kokabun/ps1-spdif-fpga/README.md

# PS1 S/PDIF FPGA PoC

> 実施順序（2026-09-04）：[SPU直結からPIOへ移行する計画](docs/direct-to-pio-plan.md)を参照してください。まずPIOを使わず直結で検証し、その後にPIOへ移行します。[共通RTL修正と検証結果](docs/rtl-backport.md)を本ブランチへ反映しました。実機は未検証です。

[SPU直結の暫定回路図・秋月購入リスト](docs/spu-direct-build.md)を追加しました。PS1側の測定を開始しましたが、電気的な適合性は未確認・施工不可です。

以下の構成を対象とする概念実証（PoC）です。

```text
SCPH-7000 / PU-20 (CXD2925Q)
        -> Tang Nano 9K (GW1NR-9)
        -> IEC 60958 / S/PDIF
        -> 秋月電子 109598 (Everlight PLT133/T10W)
```

**まだPlayStationをFPGAへ接続しないでください。** [入力回路の評価案](docs/ps1-input-interface.md)では74LCX541FTを第一候補としましたが、負電圧・入力傾斜・電源遷移が未確認です。電気的適合を確認してから接続します。左右極性・Right-Justifiedのbit位置等は、その後のFPGA受信試験でも確定できます。音声形式のTBDと接続前の電気的条件を区別します。

次の作業は[PS1未接続のLCX541単体試験](docs/input-buffer-test.md)です。端子番号付き配線図、Nano 9K専用の試験信号源、オシロスコープ（使用機：DHO914S）での手順を追加しました。Gowin実ビルド・書込み・入力基板の実測は未実施です。

PCから1コマンドずつ測定・保存する手順は[DHO914S CLI測定手順](docs/input-buffer-measurement.md)を参照してください。元データは本リポジトリ内の`captures/input-buffer/`（各runはGit管理外）、公開確認済みの資料は[入力バッファのエビデンス](docs/evidence/input-buffer/README.md)へ分けて保存します。

## 現在の実装状況

将来構想は[Parallel I/O接続型S/PDIFドングルの設計検討](docs/parallel-io-dongle.md)を参照してください。
一次資料・第三者の報告・未検証の仮説を分けて整理しています。PIO対応は未実装です。

- 移植可能な16-bit Right-Justified PCM receiver
- 移植可能な4エントリ asynchronous FIFO
- IEC 60958 consumer stereo frame generatorおよびBMC出力
- 想定される`384*Fs` WCKOから`128*Fs`への正確なclock-enable分周
- Tang Nano 9K用top、device選択、pin constraints
- 自己検証を行うreceiverおよびtransmitter testbench
- [GW1N-1](platform/tang_nano_gw1n1/README.md)および[GW1NZ-1](platform/tang_nano_1k_gw1nz1/README.md)向けplatformディレクトリの雛形

9K platformはWCKOを直接使用するため、PLLをインスタンス化しません。WCKOが
16.9344 MHz（`384 * 44.1 kHz`）であると確認できれば、WCKO 3周期ごとのpulseが
5.6448 MHzのBMC half-bit rateと正確に一致します。`audio_clock.v`はplatform固有の
wrapperとして分離しているため、測定結果に応じてcoreを変更せずgenerated rPLLへ
置き換えられます。

## 設計

```text
BCKO/LRCO/DATO -> Right-Justified RX --write--> asynchronous FIFO
                                                       |
WCKO -> platform audio_clock -> IEC 60958 + BMC <------read
                                      |
                                  PLT133/T10W
```

receiverは各LRCK slotで最後にsamplingした16 bitを保持します。`LRCK_LEFT`と
`SAMPLE_ON_NEGEDGE` parameterを公開していますが、現在のtop-level設定値は
placeholderであり、CXD2925Qのtimingを確定するものではありません。

transmitterは、channel-status blockごとに192 stereo frame、Z/X/Y preamble、
subframe bit 12〜27の16-bit audio、validity/user/channel-status、even parity、BMCを
出力します。consumer channel-status blockは現在すべて0です。これはconsumer
linear audio、no pre-emphasis、標準の44.1 kHz frequency codeを示します。
professional/copyright/category/word-lengthの詳細化は、このPoCの対象外です。

## PU-20配線候補 — 接続前に測定必須

これまでに確認したreverse-engineering資料から得た作業仮説は次のとおりです。

| CXD2925Q候補 | 機能 | Tang Nano 9K PoC header | FPGA pin |
|---|---|---|---:|
| pin 100 `WCKO` | 16.9344 MHz / 384 Fs想定 | J5-5 | 25 |
| pin 97 `BCKO` | serial bit clock | J5-6 | 26 |
| pin 98 `LRCO` | 44.1 kHz word/channel clock | J5-7 | 27 |
| pin 99 `DATO` | serial PCM | J5-8 | 28 |
| 確認済みのdigital ground | 共通基準電位 | J5 GND | — |

これらのCXD2925Q pin番号とtiming想定は**候補**であり、Sonyのtiming diagramによって
本リポジトリ内で完全に確定したものではありません。対象となるPU-20 revisionで、
ICの向きと導通を確認してください。基板写真だけからpin番号を推定しないでください。

選択したNano 9Kのpin 25〜29はJ5-5〜J5-9へ引き出されており、Sipeed公式回路図では
3.3 V I/O bankに属します。ただし、これはPS1側信号が3.3 V互換であることを証明する
ものではありません。

### LRCO / BCKO / DATO / MCLK測定のエビデンス（2026-09-06）

対象はSCPH-7000 / PU-20。測定者申告の取り出し点は、[ConsoleModsの700x向け手順](https://consolemods.org/wiki/PS1:Digital_Audio_(SPDIF)_Mod)にあるDAC側LRCK/BCK/MCLK点と、手順5の写真で示された基板GND点。
この第三者資料と測定者申告は、CXD2925Q端子までの導通確認やSony一次資料による確定とは区別する。

測定にはRIGOL DHO914S、10X passive probe、DC coupling、20 MHz bandwidth limit OFFを使用した。
測定前に本体のprobe compensation outputを測定し、約3.076 Vpp、平坦な矩形波を確認した。
PS1測定時のGNDは標準の長いワニ口leadで基板GNDへ接続したため、過渡peakにはground-loop inductanceとpickupの影響が含まれ得る。

#### LRCO（ConsoleMods表記LRCK）

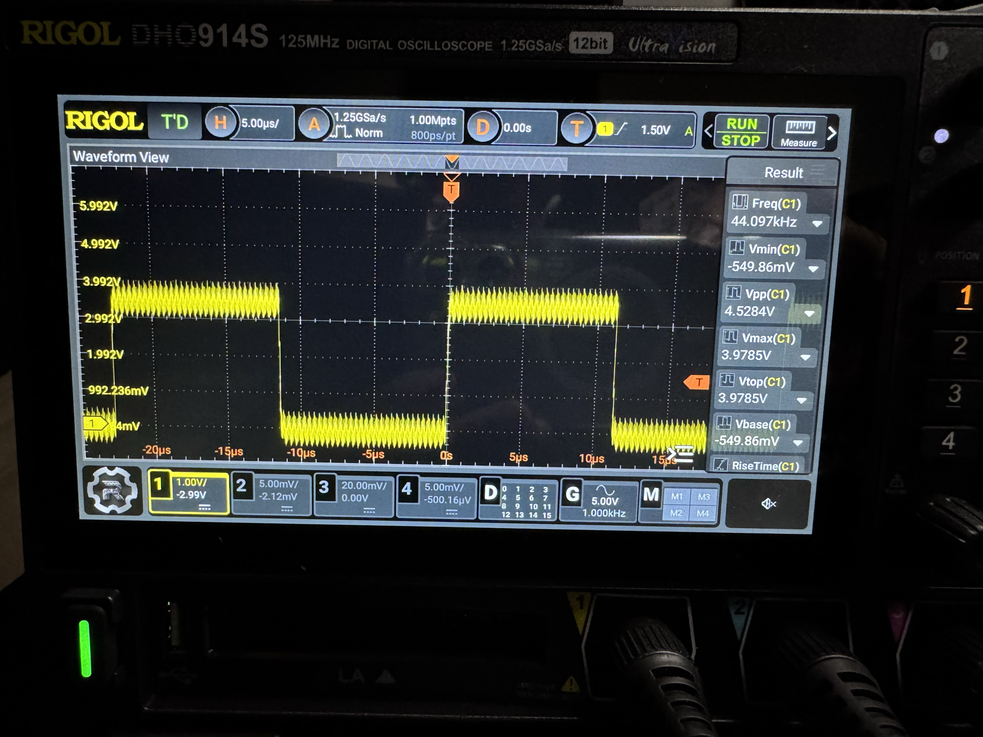
[picture p1: docs/evidence/pu20-lrck-2026-09-06.png]
PU-20 LRCO/LRCK測定：44.097 kHz


| 項目 | 確認内容・状態 |
|---|---|
| 周波数 | 10X再確認後のCH1表示44.097 kHz。先行測定44.101 kHzとも整合し、**約44.1 kHzを確認済み**とする |
| 時間軸・取得設定 | 5 µs/div、1.25 GSa/s、1.00 Mpts（写真表示） |
| peak読値 | Vmax 3.9785 V、Vmin -549.86 mV、Vpp 4.5284 V。長いground leadの影響を分離できておらず、端子保証値には使用しない |
| 未確定 | DC High/Low保証範囲、過渡peak、左右極性、slot境界、FPGA接続可否 |

#### BCKO（ConsoleMods表記BCK）

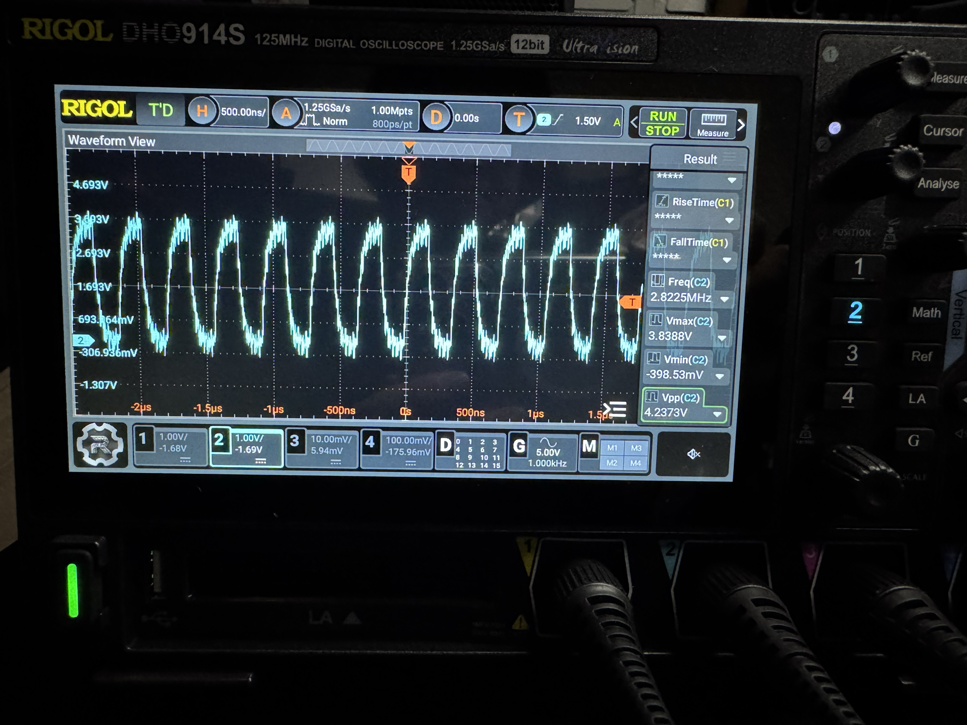
[picture p2: docs/evidence/pu20-bcko-2026-09-06.png]
PU-20 BCKO/BCK測定：2.8225 MHz


| 項目 | 確認内容・状態 |
|---|---|
| 周波数 | CH2表示2.8225 MHz。LRCO 44.097 kHzとの比は約64.01で、**約2.8224 MHz / 64 Fsを確認済み**とする |
| 時間軸・取得設定 | 500 ns/div、1.25 GSa/s、1.00 Mpts（写真表示） |
| peak読値 | Vmax 3.8388 V、Vmin -398.53 mV、Vpp 4.2373 V。基板GND直結のワニ口lead測定であり、端子保証値には使用しない |
| 未確定 | 最短周期、duty variation、edge、DATOとのsetup/hold、FPGA接続可否 |

#### DATO（ConsoleMods表記DATA）とBCKOのエッジ関係

音楽CD再生中にCH2=BCKO、CH3=DATOを同時測定した。停止中はDATOがLow付近に留まり、再生開始後にdata遷移を確認した。

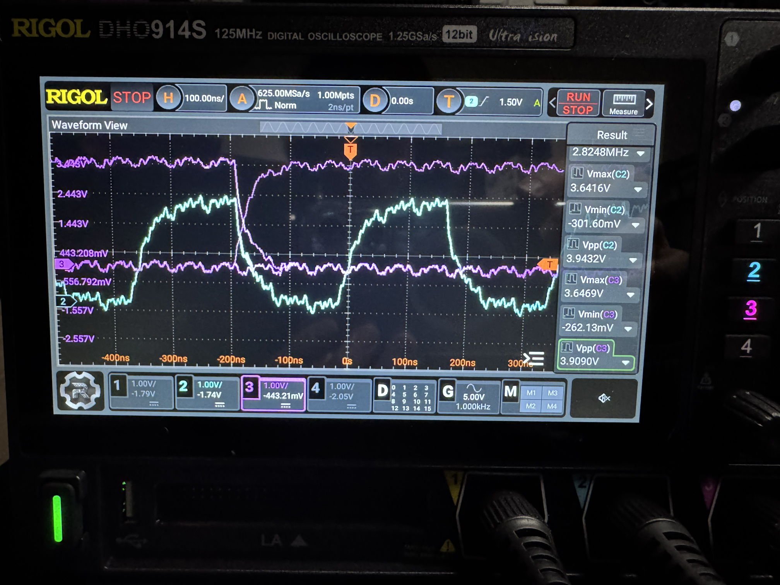
[picture p3: docs/evidence/pu20-bcko-dato-2026-09-06.png]
PU-20 BCKO/DATO測定：DATOはBCKO立下り付近で遷移


| 項目 | 確認内容・状態 |
|---|---|
| 観測したエッジ関係 | この取得ではDATO遷移がBCKO立下り付近にあり、BCKO立上り付近ではDATOが安定して見える。**BCKO立上りcaptureを第一候補**とするが、単一取得での観測であり確定しない |
| 時間軸・取得設定 | 100 ns/div、625 MSa/s、1.00 Mpts、12 bit、CH2/CH3 1 V/div、CH2立上り1.5 V trigger、10X probe（写真表示と測定者確認） |
| BCKO読値 | 2.8248 MHz、Vmax 3.6416 V、Vmin -301.60 mV、Vpp 3.9432 V |
| DATO読値 | Vmax 3.6469 V、Vmin -262.13 mV、Vpp 3.9090 V |
| 未確定 | probe間skew、正確なsetup/hold、左右極性、slot境界、16-bit Right-Justifiedのbit位置、FPGA接続可否 |

電圧読値と見かけのedge形状には長いground leadの影響が含まれ得るため、端子保証値や直結可否には使用しない。

#### ConsoleMods表記MCLK（WCKO候補）

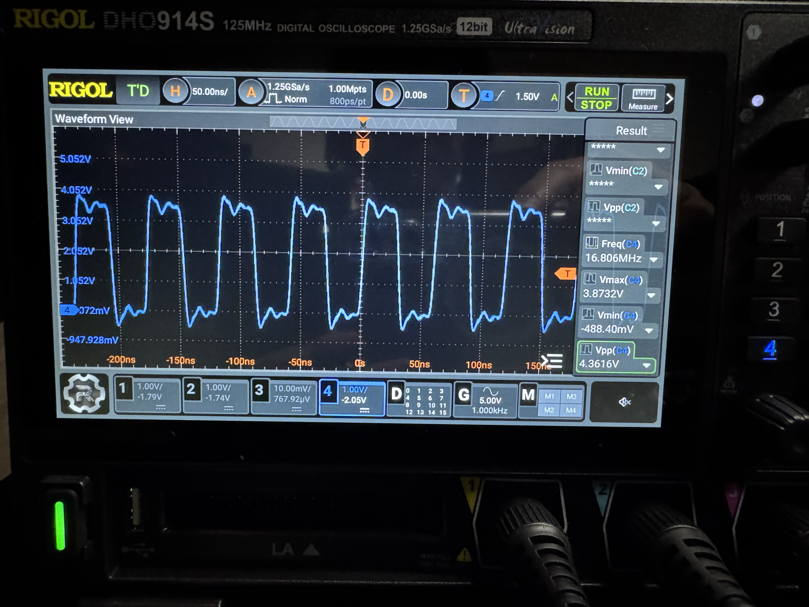
[picture p4: docs/evidence/pu20-mclk-2026-09-06.png]
PU-20 MCLK測定：16.806 MHz


| 項目 | 確認内容・状態 |
|---|---|
| 周波数 | 掲載写真のCH4表示16.806 MHz。直前の同一測定セッションでは16.949 MHzも表示された。最新値のLRCO比は約381.11、BCKO比は約5.954で、**約384 Fs / BCKOの約6倍という候補には近いが、正確な比は未確定** |
| 時間軸・取得設定 | 50 ns/div、1.25 GSa/s、1.00 Mpts、12 bit、CH4 1 V/div、10X probe（写真表示と測定者確認） |
| peak読値 | Vmax 3.8732 V、Vmin -488.40 mV、Vpp 4.3616 V。長いground leadと写真に見えるringingの影響を分離できず、端子保証値には使用しない |
| 未確定 | 16.806 MHzと直前値16.949 MHzの差の原因、公称16.9344 MHzとの一致、LRCO/BCKOとの正確な同期・位相、CXD2925Q pin 100 WCKOとの導通、FPGA接続可否 |

MCLK測定は、ConsoleModsの取り出し点が現行RTLのWCKO入力として機能する候補であることを支持するが、384 Fsの確定や、WCKOと同一netであることの一次確認にはならない。
以上は周波数と比率の実機観測記録であり、3.3 V互換や直結可能の証拠ではない。
公開用PNGはHEICを再encodeし、EXIF/XMP等の撮影metadataを引き継がないようにした。

### オシロスコープでの確認項目

以下の確認にはオシロスコープを使用します。本プロジェクトの開発者が使用する機種は
RIGOL DHO914Sですが、必要な帯域・channel数・測定機能を満たす他の機種でも確認できます。
Nano 9Kと電気的に接続する前に、console側信号をprobeしてください。

1. ground基準と、WCKO、BCKO、LRCO、DATOのDC high/low電圧を確認します。
2. LRCOが約44.1 kHz、WCKOが約16.9344 MHzであることを確認します。
3. BCKO周波数を測定し、LRCOの各half/slotに含まれるBCK cycle数を数えます。
4. 無音ではなく左右非対称のstereo test signalをdecodeします。LRCO極性、MSB/LSB順、
   最後の16-bit位置、dataがBCKO rising/falling edgeのどちらで安定するかを決定します。
5. FPGAのsampling edge候補におけるsetup/hold marginを確認します。
6. 信号levelがGW1NRの3.3 V bank制限を満たす場合だけ、共通groundと短い配線で
   接続します。満たさない場合は、先に適切なlevel shifter/bufferを設計します。
7. 接続後、loading、ringing、overshootによる波形劣化がないか再確認します。
8. S/PDIF出力の半ビットレートが5.6448 MHz（半ビット幅約177.15 ns）であることを確認し、
   receiver lockと左右channelの対応も確認します。実際の遷移回数はデータとプリアンブルに依存します。

測定後、`platform/tang_nano_9k/top.v`の2つのparameterを更新し、
[タイミング制約と波形検証](docs/timing-validation.md)に従ってSDCを完成させてください。
クロック周期だけでなく入力遅延、FIFOのクロックドメイン間経路、resetの確認が必要です。

## PLT133/T10W（秋月電子 109598）

メーカーのRev.5 datasheetでは、推奨電源電圧2.7〜5.5 V、TTL-compatible input
（`VIH >= 2.0 V`、`VIL <= 0.8 V`）、最大16 Mbps、pin機能は1=Vin、2=Vcc、3=GND、
4/5=NCと規定されています。

PoCでは次のように接続します。

```text
Tang Nano J5-9 / FPGA pin 29 (spdif_out) -> PLT133 pin 1 Vin
Tang Nano 3V3                             -> PLT133 pin 2 Vcc
Tang Nano GND                             -> PLT133 pin 3 GND
0.1 uF ceramic capacitorをpin 2とpin 3の直近へ接続
PLT133 pin 4およびpin 5                     -> 未接続
```

datasheetの指示どおり、VinとVccは同時に電源を切ってください。Nano 9KのGPIOへ5 V
logicを入力してはいけません。transmitter inputをfloatingにしないでください
（Vinがfloatingの場合、moduleのLEDが点灯する可能性があります）。

- [秋月電子 商品ページ](https://akizukidenshi.com/catalog/g/g109598/)
- [Everlight datasheet](https://www.everlighteurope.com/custom/files/datasheets/DPL-0000049.pdf)

## simulation

Icarus Verilogをinstallして、次を実行します。

```sh
make test
```

Python 3も必要です。既存単体テストに加え、FIFO容量・満杯・順序・周回・リセットと、
384Fs固定／受信エッジ2種／左右極性2種／16・32-bitスロットの8条件を検証します。
各条件で出力S/PDIFのみを復号し、419組の左右PCM、欠落・重複、音声ビット配置、
パリティ、プリアンブル、ブロック周回、枯渇時の無効フラグと左右ミュートを確認します。
正規化クロックの論理試験であり、実機電圧・同期・Gowin配置配線を保証しません。

各TXクロック周期で半ビット内の出力保持も検査します。半ビット内の後続2周期を
それぞれ壊した波形の拒否と、起動待ち時間を変えた正常波形の受入れを検証します。
クロック周期より短いグリッチや実配線遅延は、このテストの対象外です。

RX testは、末尾16 bitに異なるsampleを格納した32-bit slotを使用します。TX testは
frame request cadence、Z preamble、BMC activityを確認します。hardware-level timingと
光接続の相互運用性については、引き続き上記の実機測定が必要です。

## Gowin EDAでのbuildと書き込み（Tang Nano 9K）

1. Gowin EDAで`platform/tang_nano_9k/ps1_spdif.gprj`を開きます。
2. deviceが`GW1NR-LV9QN88PC6/I5`、top moduleが`top`であることを確認します。
3. [タイミング制約と波形検証](docs/timing-validation.md)に従い、`tang_nano_9k.sdc`の
   クロック・入力遅延・CDC制約を実測と合成後のノード名から確定します。現状は未測定テンプレートです。
4. **Synthesize**、続いて**Place & Route**を実行します。クロック配線資源、入力setup/hold、
   FIFO経路、reset、例外の適用対象を確認します。unconstrained-clock警告の解消だけでは完了しません。
5. Nano 9KのUSB portを接続し、Gowin Programmerを開きます。
6. JTAG chainをscanし、生成された`.fs`を選びます。最初の可逆な試験ではSRAMへの
   programmingを使用してください。内蔵または外部flashは検証後に使用します。
7. consoleへ接続する前に、安全なsynthetic sourceでFPGAと光送信moduleを試験します。

正確なmenu名はGowin EDAのversionによって異なります。driver/license設定については、
[Sipeed Tang Nano 9K公式資料](https://wiki.sipeed.com/hardware/en/tang/Tang-Nano-9K/Nano-9K)と
Gowin Software User Guideを参照してください。

## 既知の未確定事項／作業停止条件

- 対象PU-20におけるCXD2925Qの出力電圧とdrive能力
- BCKO sampling edgeとDATO setup/hold timing
- LRCO極性と正確なboundary behavior
- slotあたりのBCKO cycle数とsample前のpadding有無
- consoleの各audio stateにおけるWCKO周波数と位相の連続性
- 稼働中のconsole、Nano 9K、光送信module間のpower sequence

どの項目も試行的な配線で解決しないでください。作業を止め、測定し、根拠に基づいて
RTL/constraintsを更新してください。PS1のhigh levelがNano 9Kのbank定格を超える場合や、
overshootがabsolute maximumを超える場合は、level translatorが必須です。

## 参考資料とlicense

本リポジトリの独自実装はMIT licenseです。architectureの検討では、動作実績のある
[puhitaku/YOTSUHACKのTang Nano実装](https://github.com/puhitaku/nintendo-switch-i2s-to-spdif)
を参照しました。同リポジトリ全体はMITですが、Ultra-Embedded由来のS/PDIF RTLは
GPL-2.0-or-laterです。本リポジトリにはそのRTLをコピーしていません。正確な出典、
license、Sipeed公式資料については[`THIRD_PARTY.md`](THIRD_PARTY.md)を参照してください。
