kokabun/ps1-spdif-fpga/platform/tang_nano_1k_gw1nz1/README.md

# Tang Nano 1K (GW1NZ-1)

[プロジェクトREADME](../../README.md)

本書を正本とする。このplatformは未実装の雛形です。
ここには`top.v`、`audio_clock.v`、`.cst`、`.sdc`、Gowinプロジェクトのみを追加します。
共通RTLはデバイス非依存です。このplatformを有効化する前に、対象ボードの正確なrevisionで
端子とBank電圧を確認してください。
