kokabun/ps1-spdif-fpga/docs/templates/input-buffer-record.md

# 入力バッファ単体試験：測定記録ひな形

コピーして使用するひな形。**値は未測定のまま開始し、測っていない欄を埋めない。** 保存先・操作は `docs/input-buffer-measurement.md` を参照。

目次：[使用版と条件](#使用版と条件) / [事前確認](#事前確認) / [測定結果](#測定結果) / [解析と判断](#解析と判断) / [公開確認](#公開確認)

## 使用版と条件

| 項目 | 記録 |
|---|---|
| run ID / 測定日（必要な粒度のみ） | 未記入 |
| PS1 / 光送信 / FPGAへの戻り配線 | 未確認（全て未接続が前提） |
| PS1 PoC commit / 未コミット変更の有無 | 未記入 |
| ツール版 / commit / 未コミット変更の有無 | 未記入 |
| ツール実装ファイルのSHA-256（相対名と値） | 未記入 |
| Python版 | 未記入 |
| Gowin版 / 試験.fs名とSHA-256（相対名） | 未記入 |
| HALF_PERIOD / DRIVE | 未確認（初回は5 / 4の設計） |
| Nano・変換基板版 / IC型番・向き | 未確認 |
| 部品番号R1〜R6・C1/C2の値、変更点 | 未確認 |
| スイッチSW_ENABLEの固定・開閉確認 | 未確認 |
| 信号線・GNDの長さ、配線写真の相対名 | 未記入 |
| CH2＝TP1/TP_A1、CH3＝TP2/TP_Y1 | 未確認 |
| プローブ型番（シリアル不要） / 実物10X | 未確認 |
| 本体倍率・補償・GND接続方法 | 未確認 |
| プローブ間skew / deskew | 未確認・未補正 |
| 本体rise/fallの閾値設定 | 未確認（解析の10–90%とは別） |
| 本体ファームウェア（シリアル不要） / 有線・無線 | 未記入 |

IP、MAC、シリアル、氏名、個人メール、ローカル絶対パスは記入しない。必要な版情報だけ記録する。manifestは全ての物理条件・測定閾値・deskew・使用ソース版を自動収集するわけではない。

## 事前確認

- [ ] 無通電で短絡・IC向き・各接続・未使用入力GNDを確認した。
- [ ] 電源投入・書込み時はSW_ENABLEがOPENだった。
- [ ] 通電時の切替は事前に配線・固定したスイッチだけで行った。
- [ ] 動的試験で電源を入れ直すたびにSRAMへ専用イメージを再書込みした。
- [ ] 静的試験中、Nanoの信号出力は切り離した。
- [ ] 物理プローブ倍率と本体倍率を両CHで確認した。
- [ ] 初回CSV・PNGを本体表示と照合した。

| 手動確認 | 値・結果 |
|---|---|
| IC20–10 VCC | 未測定 |
| /OE OPEN時 / 閉時電圧 | 未測定 |
| 発熱・電源低下 | 未確認 |
| 接続・機種照合 / status読出し | 未実施 |
| 設定の読み戻し一致 | 未確認 |

## 測定結果

各値にはV、Hz等の単位を添える。`null` は欠測であり0ではない。画面・本体値・解析値のどれかを区別する。未実施のケースを省略して「全試験成功」としない。

| ケースID | 条件 | CH2 | CH3 | 結果・理由 |
|---|---|---|---|---|
| s10-static-low | 入力GND、有効 | 未測定 | 未測定 | 未実施 |
| s11-static-high | 入力3V3、有効 | 未測定 | 未測定 | 未実施 |
| s12-static-disabled | 入力3V3、無効 | 未測定 | 未測定 | 未実施 |
| s20-source-normal | ICなし、NORMAL | 未測定 | 対象外 | 未実施 |
| s21-source-raw10k | ICなし、RAW | 未測定 | 対象外 | 未実施 |
| s30-disabled-normal | クロック入力、無効 | 未測定 | 未測定 | 未実施 |
| s31-enabled-normal | クロック入力、有効 | 未測定 | 未測定 | 未実施 |
| s32-enabled-raw10k | クロック入力、有効 | 未測定 | 未測定 | 未実施 |
| s33-disabled-raw10k | クロック入力、無効 | 未測定 | 未測定 | 未実施 |
| s40-enabled-raw100k | 任意・有効 | 未測定 | 未測定 | 未実施 |
| s41-enabled-raw1m | 任意・有効 | 未測定 | 未測定 | 未実施 |

動的ケースごとに追記する欄：

- ZIP / 解析MD・JSON / 配線写真の相対名：未記入
- 周波数、High/Low、Vmax/Vmin/Vpp（CHごと）：未測定
- 無効時CH3 Vavg、残留変動：未測定
- 時間軸、サンプルレート、RAW点数と実サンプル間隔、CSV時刻範囲：未確認
- 波形の画面内表示、トリガ位置、MAINとRAWの対象範囲の違い：未確認
- 保存開始〜完了の経過秒数、成否：未測定
- 解析警告・欠測項目、測定条件の変更：未記入

## 解析と判断

- 基本の非反転動作：未確認
- 出力無効でのプルダウンと再有効化：未確認（Low表示だけでHi-Zの厳密証明にはしない）
- 10–90% rise/fall・伝搬遅延：未評価（補正・負荷条件を確認するまで参考値）
- 0.8〜2.0 V区間の入力傾斜：未評価（10–90%値を代入しない）
- 負側ピーク・過大ピークと測定系の影響：未評価
- 総合：未実施 / 確認できた範囲 / 要再測定を記載
- 停止理由と再開時に必要な作業：未記入

単体試験の成功は、PS1接続許可・音声形式確定・FPGA受信成功ではない。PS1側の電気的適合・保護要否・電源遷移・4信号の相対タイミング等は別途確認する。

## 公開確認

- [ ] 原本、画像表示・メタデータ、CSV/JSON、解析文、ファイル名に不要な識別情報がない。
- [ ] 公開に必要な情報だけを選んだ。
- [ ] 実測と仮説・未確認・模擬検証を区別した。
- [ ] 公開対象と範囲についてユーザーの承認を得た。
- [ ] 公開用READMEと関連資料のリンクを確認した。

公開対象の相対名・確認した範囲：未記入。原本は上書きせずローカル保存する。
