kokabun/ps1-spdif-fpga/docs/spu-direct-build.md

# SPU直結PoC：暫定回路図と秋月購入リスト

[README](../README.md) / [タイミング検証](timing-validation.md)

本書を正本とする。Rev.A。PS1側はLRCO/BCKO/MCLKの周波数とDATO/BCKOの単一波形を測定したが、電圧保証・DATOの正確なtiming/bit位置・MCLKとWCKOの同一性は未確定。**SPU側は施工不可の暫定設計**であり、保護・レベル変換を省略した直結配線を指示するものではない。
本書は調達候補を整理するものであり、現在の購入状況を示す台帳ではない。価格・在庫・販売単位は追加購入時に再確認する。

## 回路図

2026-09-10追記：[入力回路の評価案](ps1-input-interface.md)に74LCX541FTの選定根拠・論理接続・購入候補・残る接続条件をまとめた。以下の既存図の入力TBDを検討する資料であり、PS1接続許可や施工図の完成を意味しない。音声形式の確定は電気的適合確認後のFPGA試験でも進められる。

SPU直結PoC暫定回路図

[拡大できるSVG回路図](spu-direct-circuit.svg)。上段は未確定インターフェース図、下段は部品値付きの光送信回路案。
基板レイアウトや部品の表裏図ではない。SVGは編集可能だがEDA回路データではなく、ERC・PCB製造データは含まない。

## ユニバーサル基板への配置イメージ

光送信基板の部品配置・配線イメージ

[拡大できるSVG配置図](spu-direct-layout.svg)。第一候補のAE-3G（72×47.5mm）を想定した概念図であり、穴番号を指定する実装図ではない。
PLT133/T10Wを光コネクターが基板外向きになる端へ置き、接続用J1と信号切離し用JP1を反対側へ置く。
C1はU1のVcc–GND端子へ最短で配置する。C2は電源入口寄り、R1はVin–GND間に配置する。

チェック端子は4点とする。

| チェック端子 | ネット | 測る内容 |
|---|---|---|
| TP1 | 3V3 | 無負荷・U1動作時の電圧、電源変動 |
| TP2 | GND | 全測定の基準。TP4の近くに置き、プローブGNDを短くする |
| TP3 | SPDIF_SRC | JP1よりFPGA側。FPGA出力だけを確認 |
| TP4 | SPDIF_VIN | JP1よりU1側。U1を接続した状態の波形を確認 |

部品面から見た配置と、配線面を部品面から透視した図を併記している。
実際に基板裏側を見て配線すると左右が反転するため、印刷した図をそのまま裏面の穴位置へ写さない。
導通確認では、図の色ではなく接続表を正本とする。未使用穴を信号間に残し、裸線同士を交差させない。
基板の型番が確定したら、実穴数、取付穴、PLT固定脚、J1の向きに合わせた穴番号付き実装図へ更新する。

### 秋月電子のユニバーサル基板候補

第一候補は**AE-3G**。初めてのユニバーサル基板製作で配線・測定点に余裕を持たせるため、Cタイプを選ぶ。
両面スルーホールなので部品面からもはんだ付け状態を確認しやすく、FR-4・厚さ1.6mmはPLT133/T10Wのメーカー実装例の基板厚1.6mmと一致する。
ただし、厚さの一致は固定脚の穴形状まで適合することを意味しない。

| 優先 | 秋月商品 | 仕様 | 評価 |
|---|---|---|---|
| 第一候補 | [100189 AE-3G 両面スルーホール・FR-4 Cタイプ](https://akizukidenshi.com/catalog/g/g100189/) | 72×47.5×1.6mm、2.54mm、穴径1mm、取付穴3.2mm | 配置余裕と配線作業性を優先。本配置図の想定品 |
| 第二候補 | [103231 両面スルーホール・CEM-3 Cタイプ](https://akizukidenshi.com/catalog/g/g103231/) | 72×47mm、2.54mm | 同じCサイズの代替候補。購入前に最新寸法図を確認 |
| 小型化候補 | [108241 AE-D1 片面 Dタイプ](https://akizukidenshi.com/catalog/g/g108241/) | 47×36×1.6mm、2.54mm、穴径1mm | 回路自体は収まり得るが、初回製作では測定点・固定・配線余裕が少ない |

十字配線や電源レール付き基板は既設パターンの切断確認が増えるため、今回の初回製作では独立ランド型を優先する。
AE-3Gを**2枚**購入し、1枚を加工・練習または失敗時の予備にする案を推奨する。
PLT133/T10Wの電気端子は幅0.5mmとされるが、固定脚を含めてAE-3Gの1mm丸穴にそのまま入るとは確認できていない。
購入後、はんだ付け前に現物を当て、メーカー図と照合する。入らない場合は寸法に合う穴／長穴を加工し、端子を曲げて無理に合わせない。

## 購入できる部材

光送信基板1枚分。Tang Nano 9Kと対応USBケーブルは既存品を前提とする。
コンデンサは手はんだしやすいリード品を選ぶ。

| 図中記号 | 商品・秋月リンク | 使用数 | 購入単位の目安 | 根拠・用途 |
|---|---|---:|---|---|
| PCB | [100189 AE-3G 両面スルーホール・FR-4 Cタイプ](https://akizukidenshi.com/catalog/g/g100189/) | 1 | **2枚推奨** | 72×47.5×1.6mm、2.54mm独立ランド。配置図の想定品。U1固定脚は現物合わせが必要 |
| U1 | [109598 PLT133/T10W](https://akizukidenshi.com/catalog/g/g109598/) | 1 | 1個 | 既存PoCの光送信機。ドライバ内蔵 |
| C1 | [113582 0.1µF50V X7R・2.54mm](https://akizukidenshi.com/catalog/g/g113582/) | 1 | 10個入×1パック | RDER71H104K0P1H03B。メーカー回路の0.1µFに対応。無極性 |
| C2 | [117897 10µF50V・ルビコンPX](https://akizukidenshi.com/catalog/g/g117897/) | 0〜1 | 1個（予備込み2個でも可） | 補助平滑の設計提案。任意。＋を3V3、−をGND |
| R1 | [125103 1/4W 10kΩ](https://akizukidenshi.com/catalog/g/g125103/) | 1 | 100本入×1袋 | VinをLowへ保つプルダウン。メーカー指定抵抗ではない |
| J1・JP1 | [100167 ピンヘッダー1×40](https://akizukidenshi.com/catalog/g/g100167/) | 3極＋2極 | 1本 | 切り分けて入力端子・信号切離し端子に使用。余りはテスト端子にも使える |
| JP1用 | [103890 つまみ付きジャンパーピン・2.54mm](https://akizukidenshi.com/catalog/g/g103890/) | 1 | 20個入×1パック | 出荷／初期状態は外す。電源OFF時だけ操作 |
| 配線候補 | [103475 メス–メス15cm・黒](https://akizukidenshi.com/catalog/g/g103475/) | 必要分 | 1セット | GND等の仮接続用。Nano側もオス端子が実装済みの場合 |
| 配線候補 | [103476 メス–メス15cm・青](https://akizukidenshi.com/catalog/g/g103476/) | 必要分 | 1セット | 電源／信号用は両端をラベルで識別。15cmが高速信号に適切と保証するものではない |
| 測定用・推奨 | [107591 チェック端子TEST-1(BK)](https://akizukidenshi.com/catalog/g/g107591/) | 4 | 10個入×1パック | TP1=3V3、TP2=GND、TP3=SPDIF_SRC、TP4=SPDIF_VIN。ヘッダーで代用可 |
| 固定用・候補 | [107566 ナイロンスペーサーM3・10mm](https://akizukidenshi.com/catalog/g/g107566/) | 4 | 4個 | 基板の穴径に適合する場合。ねじ／ナットは基板決定後に合わせる |
| 調整予備・未実装 | [103941 1/4W 33Ω](https://akizukidenshi.com/catalog/g/g103941/) | 0 | 必要なら100本入×1袋 | リンギング対策候補。現図には入れず、必要時にFPGA出力直近へ追加して再測定 |

**C1は1個しか使わないが、113582は10個入り。** 型番末尾や販売コードを見て、チップ品やY5V品と取り違えない。
R1用の100本袋やジャンパ20個袋は余りが多いため、同仕様の手持ち品があれば購入不要。

### 今回まだ購入を確定しないもの

- PS1→FPGAのバッファ、レベル変換器、保護素子、それらの電源回路：測定後に選ぶ。汎用I²C向け双方向変換基板を音声クロックへ流用しない。
- SPU取り出し用の細線・固定方法・コネクター：対象基板の取り出し点と機械的な負担を確認して選ぶ。15cmジャンパをICの足へ直接付ける施工案ではない。
- 固定ねじ・ナット：AE-3Gの取付穴径3.2mmと、最終的な設置方法に合わせる。PLTの固定脚用加工とは別に選定する。
- 角型TOSLINKケーブル、44.1kHz stereo PCM対応の光入力DAC／アンプ：必要だが、今回の検索で適切な秋月販売品を確認できていない。手持ち品か別店舗で用意する。PLR135等の受光素子単体はDACの代わりにならない。
- はんだごて・フラックス・吸取線・テスター等は手持ちを確認して別途選定。専用の外部3.3V電源は本案では購入しない。

## Tang Nano 9K側のブレッドボードPoC

まずPS1を接続せず、Nanoの書込み・出力ピン・電圧を確認し、その後に光送信基板を接続する。
Nano本体は絶縁した台へ固定し、実装済みオスヘッダーから短いジャンパーワイヤでブレッドボードへ引き出す構成とする。
ブレッドボードへ本体を直接挿す場合は、ヘッダー間隔、空き穴、裏面部品の接触を現物で確認する。以下は穴番号を指定する実装図ではない。

Tang Nano 9KブレッドボードPoC修正版回路図

[拡大できる修正版SVG](spu-direct-breadboard.svg)。現行の接続表を正本として描き直し、Nanoの3V3とUSB 5Vを分離した。
電源用C1/C2はU1のVcc–GND間、R1はSPDIF_VIN–GND間に置き、PS1側4信号は未接続として示している。

### 追加で用意するもの

光送信側の購入表と合わせて使う。R1・C1・C2をNano側にも重複実装する指示ではない。

| 部品 | 使用数の目安 | 用途・選び方 |
|---|---:|---|
| Tang Nano 9K、データ通信対応USB-Cケーブル | 各1 | 手持ち品を使用。USB給電と書込み用 |
| 2.54mmオスピンヘッダー | 必要分 | Nanoが未実装の場合のみ。必要な信号・電源端子を実装 |
| [秋月100315 EIC-801](https://akizukidenshi.com/catalog/g/g100315/) | 1 | 仮配線用。電源レールの分断・内部導通はテスターで確認 |
| メス–オスの2.54mmジャンパーワイヤ（Dupont線） | 3本以上 | Nanoのオスヘッダー→ブレッドボードの信号・3V3・GND用。短いものを選ぶ |
| [秋月100288 ブレッドボード・ジャンパーワイヤ](https://akizukidenshi.com/catalog/g/g100288/) | 1セット | ボード内の穴間配線用。メス–オス線とは別物 |
| 33Ω・1/4W | 0〜1本 | 任意のシリーズ抵抗。既存購入表の調整予備を使用 |
| 測定用ヘッダー／チェック端子 | TP-A・TP-B・近傍GND用 | 既存TP1〜TP4に加える測定点。長い枝線を作らない |

Dupont線は2.54mmピンヘッダー等に使うジャンパーワイヤの通称。
**メス–オス**はNanoのオスヘッダーとブレッドボード、**オス–オス**はブレッドボード内、**メス–メス**は両側がオスヘッダーの基板間に使う。
端子の性別は現物に合わせる。既存表のメス–メス線だけでは、ブレッドボードの穴へ直接挿せない。
線色だけに頼らず両端へネット名を付け、信号とGNDを近接させて短く配線する。ブレッドボードとジャンパーの寄生成分を含めて実測する。

### 出力の配線と33Ωの比較

```text
Nano FPGA29 / J5-9 (spdif_out, LVCMOS33)
  │
  ├─ TP-A（抵抗よりFPGA側）
  │
  └─ [短絡ジャンパー または Rs=33Ω] ─ TP-B ─ 光基板 J1-3 / TP3
      Nano出力直近、電源OFFで交換                     │ SPDIF_SRC
                                                   JP1（初期OPEN）
                                                     │ SPDIF_VIN
                                                     ├─ TP4 ─ U1-1 Vin
                                                     └─ R1=10kΩ ─ GND

Nano 3V3 ─ 光基板 J1-1 / TP1 ─ U1-2 Vcc
Nano GND ─ 光基板 J1-2 / TP2 ─ U1-3 GND（共通GND）
U1-2 ─ C1=0.1µF ─ U1-3（端子直近、必須）
U1-2 ─ C2=10µF  ─ U1-3（任意、＋はU1-2）
U1-4 / U1-5：NC、未接続
U1 PLT133/T10W ─ TOSLINK ─ 光入力DAC／アンプ
```

FPGA29はFPGAのパッケージ端子番号、J5-9はNanoヘッダー番号であり、「ヘッダーの29番」ではない。
既存CSTの`spdif_out`は29、LVCMOS33、DRIVE=8。電源は本書の設計どおりNanoの**3V3**を用い、USBの5Vを光基板の3V3ネットへ接続しない。
PLT133/T10Wの端子番号・推奨電源範囲・C1は下記メーカー資料と照合済み。メーカー測定回路の5V表記を本PoCの給電指示として転記しない。
実装時の端子の左右はデータシートの視点と現物で確認する。

Rsは既存回路図では未実装。まず短絡ジャンパーで導通させ、必要時に33Ωへ交換して比較する。抵抗もジャンパーもない開放状態を「抵抗なし」としない。
Rsを長い引出し線の末端に置かず、Nano出力直近へ配置する。33Ωは確定した終端値ではなく、レベル変換・過電圧保護・75Ω同軸S/PDIF出力回路の代用にもならない。
TP-BとTP3は同じネットだが物理位置が異なる。必要に応じて受信端TP4でも波形を確認する。
R1=10kΩはJP1よりU1側のVinプルダウンであり、TP-Aへ移したり追加したりしない。

### 測定手順と記録

1. 電源OFFで3V3–GNDの短絡、ヘッダー位置、ブレッドボードの導通、U1端子、C2極性を確認。JP1はOPEN、PS1入力は未接続とする。
2. Nano単体で書込みと出力方向を確認する。PS1信号がない状態で既存RTLから有効な音声S/PDIFが出るとは仮定しない。動的波形の比較には、入力未接続でも動作する検証用信号源／FPGA構成が別途必要となる。
3. 電源OFFで光基板の3V3・GND・信号を接続。TP1をTP2基準で測り、電圧と起動時変動を確認する。Nano・ブレッドボード・光基板のGNDを共通化する。
4. 出力電圧確認後、電源OFFでJP1を閉じる。TP-A、TP-B、TP3、TP4を近傍GND基準で測る。プローブGNDを短くし、High/Low電圧、立上り／立下り、オーバーシュート／アンダーシュート、リンギングを記録する。
5. 電源OFFで短絡ジャンパーを33Ωへ交換し、同じ信号・配線長・プローブ条件で再測定する。光入力機器のロックと音声確認は、有効なS/PDIFフレームを出せる段階で行う。

測定記録にはFPGA構成、Rsの有無、JP1状態、負荷、3V3実測値、測定点、配線長、プローブ倍率・帯域設定を残す。書込み前には電源OFFでJP1をOPENへ戻す。

### PS1入力側は実測後に確定

既存CST上の割当はWCKO（MCLK）=FPGA25/J5-5、BCKO=26/J5-6、LRCO=27/J5-7、DATO=28/J5-8。
これは接続先候補であり、PS1からの直結許可ではない。
2026-09-06の測定ではLRCO 44.097 kHz、BCKO 2.8225 MHz（約64 Fs）を確認した。ConsoleMods表記MCLKでは16.806 MHzを撮影し、直前に16.949 MHzも観測したが、公称16.9344 MHz、384 Fs、WCKOとの同一性はまだ確定しない。
音楽CD再生中の単一取得ではDATOがBCKO立下り付近で遷移し、立上りcaptureを第一候補としたが、probe間skew、正確なsetup/hold、slot境界、bit位置は未確定である。
測定写真・条件・peak読値の扱いは[READMEの実機測定記録](../README.md#pu20-audio-evidence-2026-09-06)を参照する。
PS1信号のHigh/Low電圧、負側を含む過渡電圧、入力傾斜、電源順序を確認して入力回路の電気的適合を確定する。74LCX541FTを第一候補とする評価案は上記リンクを参照。左右極性・データ境界は、電気的適合確認後のFPGA受信試験でも確定できる。
TC74HC4050AP等の特定部品は現時点で確定しない。入力側のGND・取り出し点も現物で確認し、未確定インターフェースをジャンパーでバイパスしない。

既存SVGは光送信基板の配置・回路図として上記の相対参照を維持する。追加のブレッドボードPoC配線は本節を正本とする。
照合資料：[既存CST](../platform/tang_nano_9k/tang_nano_9k.cst)、[Sipeed公式回路図](https://dl.sipeed.com/fileList/TANG/Nano%209K/2_Schematic/Tang_Nano_9k_3672_Schematic.pdf)、[Everlight PLT133/T10W Rev.5](https://www.everlighteurope.com/custom/files/datasheets/DPL-0000049.pdf)。確認日：2026-09-05。

## 光送信側の接続表

| ネット | 接続する端子 |
|---|---|
| 3V3 | J1-1、U1-2 Vcc、C1片側、C2＋（実装時） |
| GND | J1-2、U1-3、C1もう片側、C2−（実装時）、R1片側 |
| SPDIF_SRC | J1-3（Nano FPGA29 / J5-9から）、JP1-1 |
| SPDIF_VIN | JP1-2、U1-1 Vin、R1もう片側 |
| NC | U1-4、U1-5：GND等へ結線しない |

J1の番号は**今回の小基板で新規に定義した番号**であり、Tang Nanoのヘッダー番号ではない。
J1-1/J1-2のNano側接続点は公式回路図と現物表示で3V3/GNDを特定する。PS1電源から給電しない。
JP1は信号だけを切り離す手動部品。電源・GNDの切断、自動保護、PS1側の絶縁機能はない。

## 値と回路の根拠

- **メーカー資料**：PLT133/T10Wは推奨電源2.7〜5.5V、端子1=Vin、2=Vcc、3=GND、4/5=NC。回路例に0.1µFを使用。C1はU1の電源端子間へ最短で配置する。長い線の先のコンデンサでは代用しない。[Everlight Rev.5、2〜4ページ](https://www.everlighteurope.com/custom/files/datasheets/DPL-0000049.pdf)
- **今回の設計提案**：Nanoと光送信機を同じ3.3V系統で給電。メーカーの消費電流上限10mAは表の試験条件Vcc=5V等に基づく値であり、Nano全体の供給余力を証明しない。追加負荷・起動時の電圧・電源順序は実測する。
- **今回の設計提案**：C2=10µFは補助。必須のメーカー指定ではなく、配線や電源変動に応じて使う。C1は省略しない。
- **今回の設計提案**：R1=10kΩはJP1開放時／FPGA高インピーダンス時にVinを浮かせないため。3.3V High時の負荷は約0.33mA。FPGA内蔵pull-up等と競合しないか起動時に測定する。Lowを保証する自動保護回路ではない。
- **メーカー資料＋運用**：VinとVccの電源OFFを揃える。JP1は初期OPEN。書込み前は電源OFFでOPENへ戻す。最初はNanoだけで書込み、ピン方向・信号電圧を確認してから、電源OFFで光基板を接続／JP1を閉じる。通電中の差替えはしない。

## SPU側を完成させる条件

図のCXD2925Q 97/98/99/100は[第三者ピン資料](https://psx-spx.consoledev.net/pinouts/)に基づく候補。Sony一次資料や現物導通による確定ではない。
まず電源基板には触れず、対象PU-20の取り出し点とGNDを確認する。FPGAへ接続する前に入力回路の電圧・過渡応答・電源条件を確認する。左右極性・16-bit RJ境界はその後の受信試験でも確認できる。
保護・変換回路と配線を電気的条件に基づいて確定し、CST/SDCは実測・合成結果を反映する。未確認の入力回路をバイパスしない。
Nano入力25〜28、光出力29は[既存CST](../platform/tang_nano_9k/tang_nano_9k.cst)と[Sipeed公式回路図](https://dl.sipeed.com/fileList/TANG/Nano%209K/2_Schematic/Tang_Nano_9k_3672_Schematic.pdf)が根拠。クロック配線資源の配置配線検証は別途必要。

通電前にC2極性、U1端子の表裏、電源短絡、NC端子、JP1開放をテスターで確認する。光送信回路の製作と電圧・信号試験が完了しても、未測定のPS1へ接続する根拠にはならない。
