kokabun/ps1-spdif-fpga/(commit log)

2026-09-02 feat: PS1 S/PDIF変換PoCを実装
2026-09-02 docs: Parallel I/O接続型S/PDIFドングルの設計検討を追加
2026-09-04 docs: SPU直結からPIO接続への段階計画を追加
2026-09-04 fix: 直結PoCへ共通RTL修正と復号テストを反映
2026-09-04 chore: 機密ファイル・IDE設定・FPGA生成物をgitignoreに追加
2026-09-04 fix: S/PDIF波形検証とタイミング制約の雛形を改善
2026-09-05 docs: SPU直結PoCの暫定回路図と秋月購入リストを追加
2026-09-05 docs: SPU直結基板の配置案と購入候補を追加
2026-09-06 docs: Tang Nano 9Kのブレッドボード検証手順と回路図を追加
2026-09-06 docs: PU-20音声信号の実測結果を追加
2026-09-12 docs: LCX541入力回路の評価案と接続条件を追加
2026-09-13 feat: 入力バッファ単体試験環境を追加
2026-09-13 docs: 英語文書を削除し日本語構成に統一
